andrew-jacobs/hz-maker/schematic/ExpressPCB/hz-maker.png

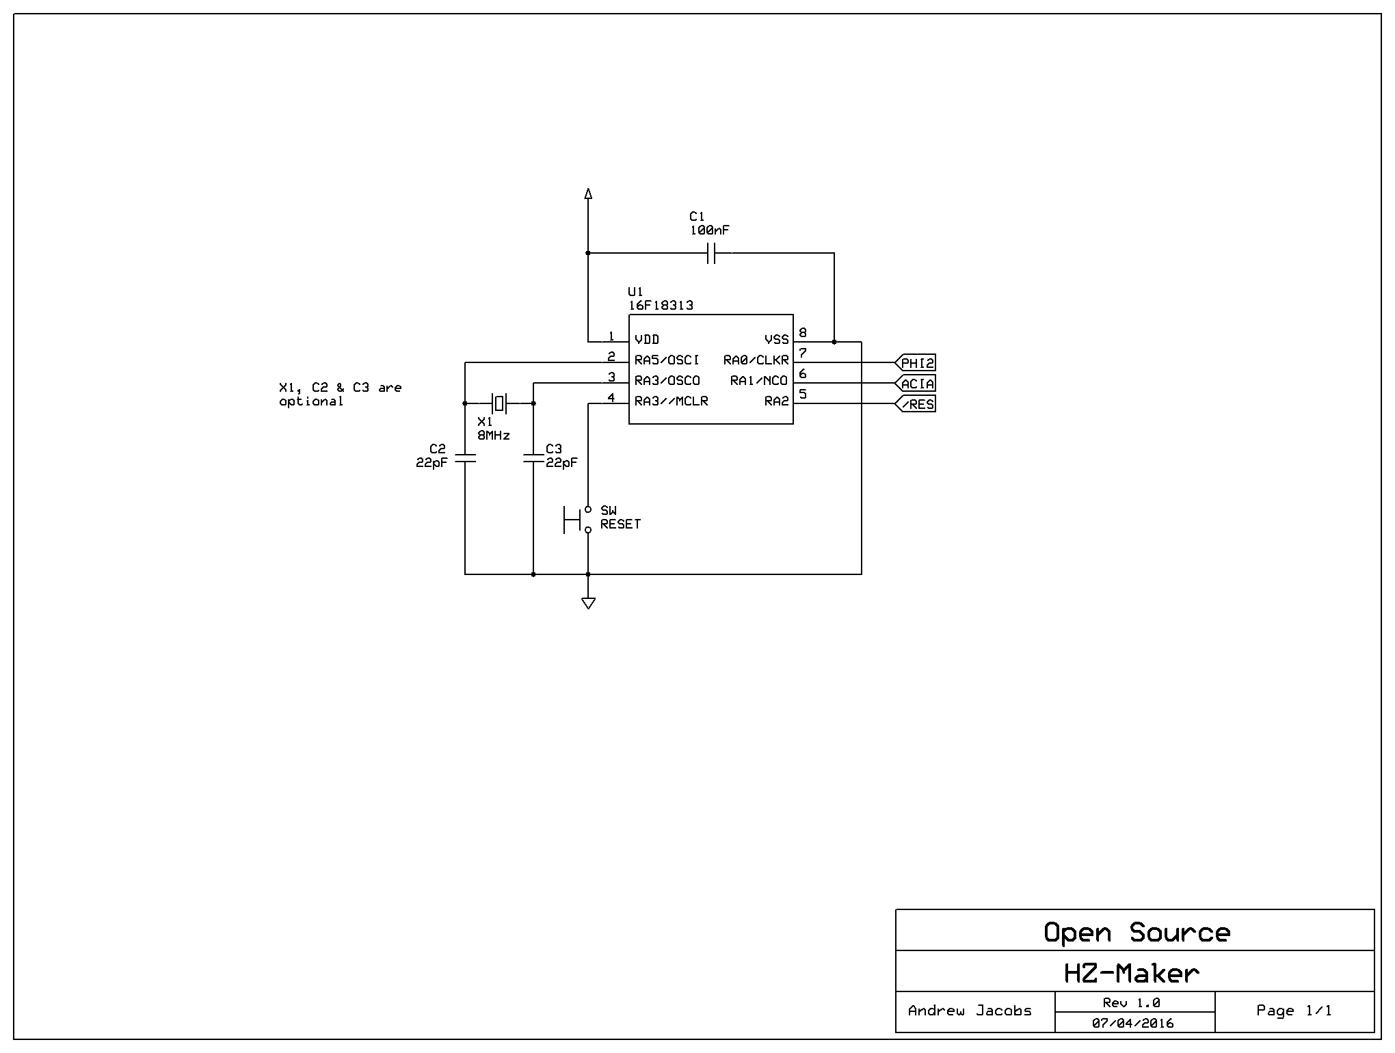
schematic/ExpressPCB/hz-maker.png
